baldusi/BalduHandbrake/hardware/BalduHandbrake-Connections-1.1-ADS1115.pdf

# BalduHandbrake v1.1

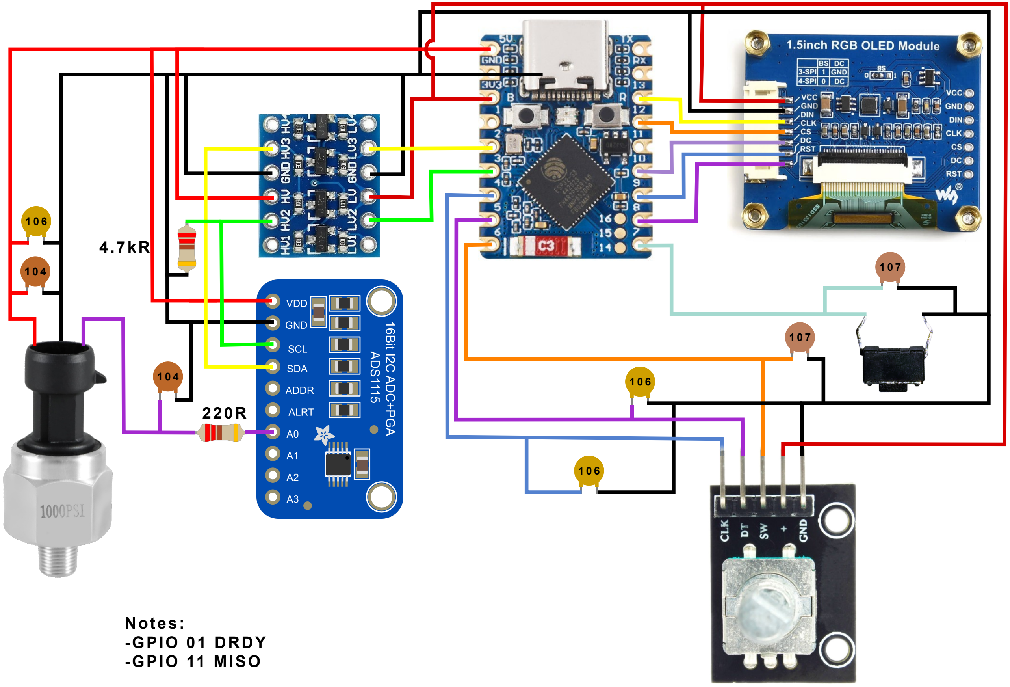
[picture p6: figure]
Notes: -GPIO 01 DRDY -GPIO 11 MISO
