baldusi/BalduHandbrake/hardware/BalduHandbrake-Connections-1.1-ADS122C04.pdf

# BalduHandbrake v1.1

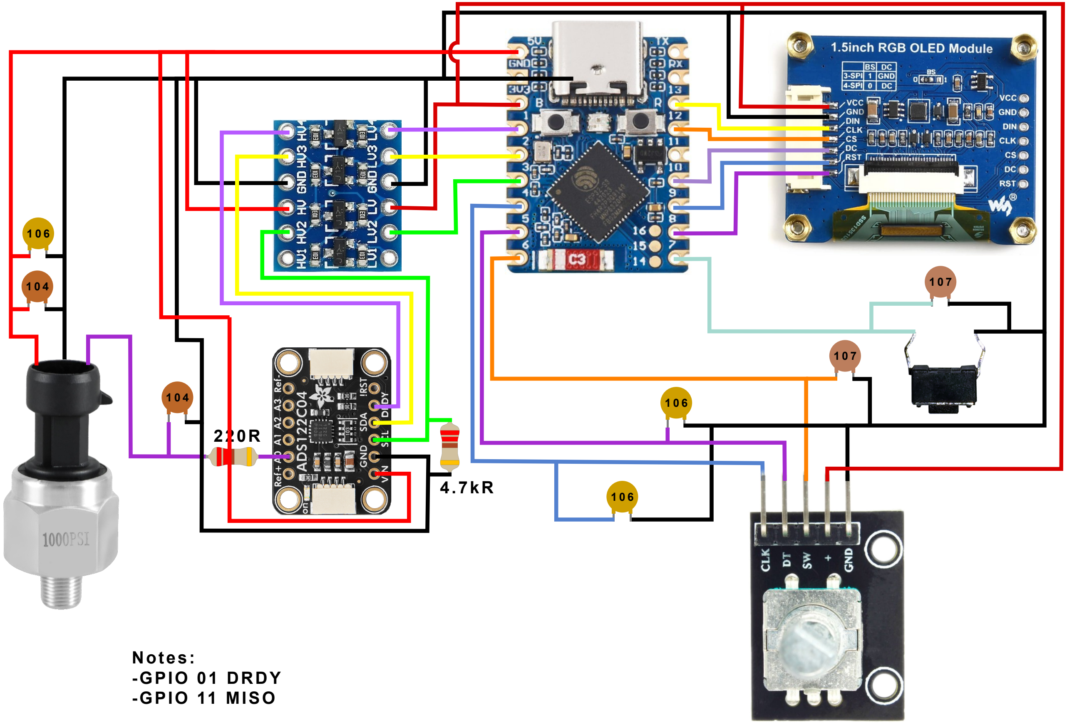
[picture p7: figure]
Notes: -GPIO 01 DRDY -GPIO 11 MISO
