baldusi/BalduHandbrake/images/5VPressure Transducer 1000psi.png

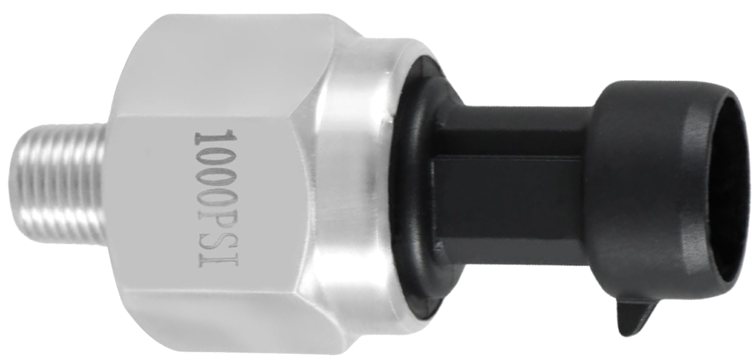
images/5VPressure Transducer 1000psi.png
