baldusi/BalduHandbrake/images/Adafruit-ADS122C04-QWIic01.png

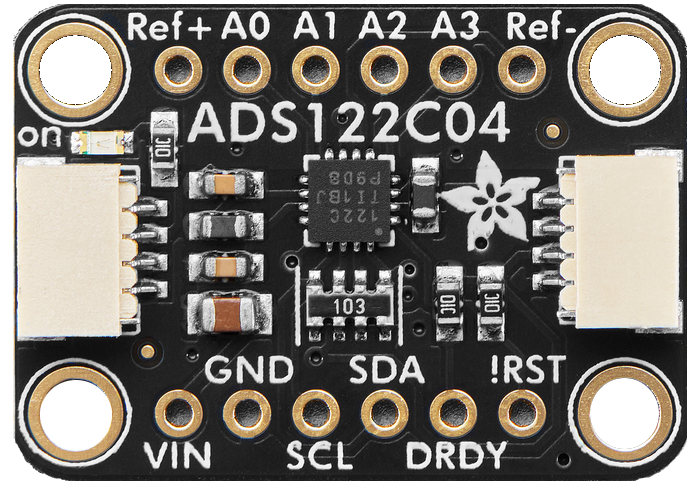
images/Adafruit-ADS122C04-QWIic01.png
