baldusi/BalduHandbrake/images/Adafruit-NAU7802-STEMMA-QT.png

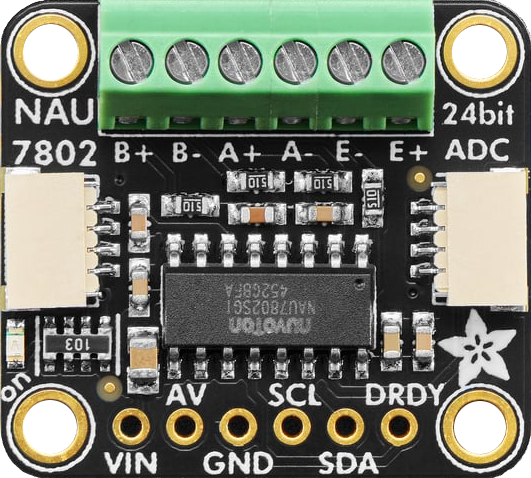
images/Adafruit-NAU7802-STEMMA-QT.png
