baldusi/BalduHandbrake/images/KY-040-RotaryEncoder-KY-040b.png

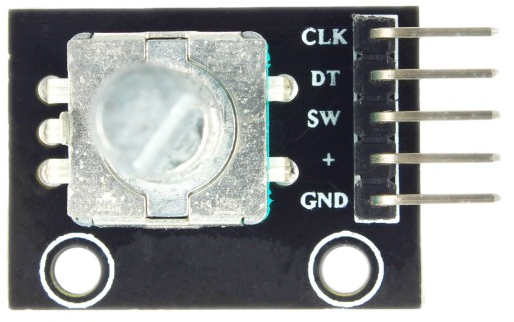
images/KY-040-RotaryEncoder-KY-040b.png
