baldusi/BalduHandbrake/images/ScrSht-LIVE01-FullData01.png

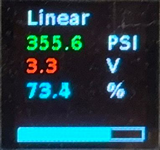
images/ScrSht-LIVE01-FullData01.png
