baldusi/BalduHandbrake/images/XFW-HX711.png

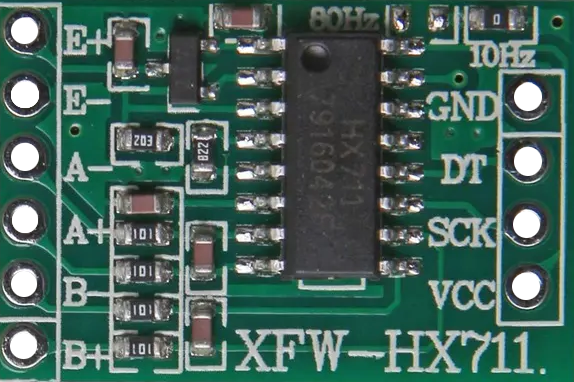
images/XFW-HX711.png
