baldusi/BalduHandbrake/hardware/BOM.xlsx

Sheet: ADS1115
Qty | Parts
1 | Waveshare ESP3-S3 Zero | https://www.amazon.com/waveshare-Mini-Development-Board-ESP32-S3FH4R2/dp/B0CS6VS1DJ/ref=sr_1_2
1 | 1/8 NPT 5V 500psi/1000psi Pressure Transducer | https://www.amazon.com/gp/product/B0CRQXGMWD/ref=ox_sc_act_title_3?th=1
1 | ADS1115 Module | https://www.amazon.com/HiLetgo-Converter-Programmable-Amplifier-Development/dp/B01DLHKMO2
1 | Logic Voltage Converter | https://www.amazon.com/SparkFun-12009-Logic-Converter-Bi-Directional/dp/B088FYQJYZ/ref=sr_1_4
1 | SSD1351 Module | https://www.amazon.com/1-5inch-RGB-OLED-Module-Interface/dp/B07V579YK2/ref=sr_1_1
1 | Momentary Button | https://www.amazon.com/uxcell-Momentary-Button-Switch-Mounting/dp/B0D5L7H9D2/ref=sr_1_4
1 | KY-040 Rotary Encoder | https://www.amazon.com/KY-040-Degrees-Encoder-15%C3%9716-5mm-Potentiometer/dp/B09LVG8ZGR/ref=sr_1_4
1 | 220 Ohm Resistor
1 | 4.7k Ohm Resistor
2 | 104 Capacitor
3 | 106 Capacitor
2 | 107 Capacitor

Sheet: ADS122C04
Qty | Parts
1 | Waveshare ESP3-S3 Zero | https://www.amazon.com/waveshare-Mini-Development-Board-ESP32-S3FH4R2/dp/B0CS6VS1DJ/ref=sr_1_2
1 | 1/8 NPT 5V 500psi/1000psi Pressure Transducer | https://www.amazon.com/gp/product/B0CRQXGMWD/ref=ox_sc_act_title_3?th=1
1 | ADS122C04 Module | https://www.adafruit.com/product/6432
1 | Logic Voltage Converter | https://www.amazon.com/SparkFun-12009-Logic-Converter-Bi-Directional/dp/B088FYQJYZ/ref=sr_1_4
1 | SSD1351 Module | https://www.amazon.com/1-5inch-RGB-OLED-Module-Interface/dp/B07V579YK2/ref=sr_1_1
1 | Momentary Button | https://www.amazon.com/uxcell-Momentary-Button-Switch-Mounting/dp/B0D5L7H9D2/ref=sr_1_4
1 | KY-040 Rotary Encoder | https://www.amazon.com/KY-040-Degrees-Encoder-15%C3%9716-5mm-Potentiometer/dp/B09LVG8ZGR/ref=sr_1_4
1 | 220 Ohm Resistor
1 | 4.7k Ohm Resistor
2 | 104 Capacitor
3 | 106 Capacitor
2 | 107 Capacitor

Sheet: ADS122C04-Load Cell
Qty | Parts
1 | Waveshare ESP3-S3 Zero | https://www.amazon.com/waveshare-Mini-Development-Board-ESP32-S3FH4R2/dp/B0CS6VS1DJ/ref=sr_1_2
1 | NA151 Single Point Load Cell Mechanic to Electronic Switch Weight Sensor (200kg) | https://www.amazon.com/Single-Mechanic-Electronic-Switch-Weight/dp/B088GY1HFL/ref=sr_1_7
1 | ADS122C04 Module | https://www.adafruit.com/product/6432
1 | SSD1351 Module | https://www.amazon.com/1-5inch-RGB-OLED-Module-Interface/dp/B07V579YK2/ref=sr_1_1
1 | Momentary Button | https://www.amazon.com/uxcell-Momentary-Button-Switch-Mounting/dp/B0D5L7H9D2/ref=sr_1_4
1 | KY-040 Rotary Encoder | https://www.amazon.com/KY-040-Degrees-Encoder-15%C3%9716-5mm-Potentiometer/dp/B09LVG8ZGR/ref=sr_1_4
2 | 220 Ohm Resistor
1 | 4.7k Ohm Resistor
4 | 104 Capacitor
3 | 106 Capacitor
2 | 107 Capacitor

Sheet: NAU7802
Qty | Parts
1 | Waveshare ESP3-S3 Zero | https://www.amazon.com/waveshare-Mini-Development-Board-ESP32-S3FH4R2/dp/B0CS6VS1DJ/ref=sr_1_2
1 | NA151 Single Point Load Cell Mechanic to Electronic Switch Weight Sensor (200kg) | https://www.amazon.com/Single-Mechanic-Electronic-Switch-Weight/dp/B088GY1HFL/ref=sr_1_7
1 | NAU7802 Module | https://www.amazon.com/Acquisition-Electronic-Collection-Biomedical-Automation/dp/B0GXJB7GX5
1 | SSD1351 Module | https://www.amazon.com/1-5inch-RGB-OLED-Module-Interface/dp/B07V579YK2/ref=sr_1_1
1 | Momentary Button | https://www.amazon.com/uxcell-Momentary-Button-Switch-Mounting/dp/B0D5L7H9D2/ref=sr_1_4
1 | KY-040 Rotary Encoder | https://www.amazon.com/KY-040-Degrees-Encoder-15%C3%9716-5mm-Potentiometer/dp/B09LVG8ZGR/ref=sr_1_4
2 | 220 Ohm Resistor
1 | 4.7k Ohm Resistor
4 | 104 Capacitor
3 | 106 Capacitor
2 | 107 Capacitor
