baldusi/BalduHandbrake/images/ScrSht-NavMode07-Calibration02.png

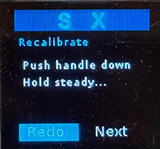
images/ScrSht-NavMode07-Calibration02.png
