baldusi/BalduHandbrake/images/ScrSht-NavMode07-Calibration03.png

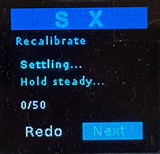
images/ScrSht-NavMode07-Calibration03.png
