baldusi/BalduHandbrake/images/ScrSht-NavMode07-Calibration04.png

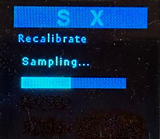
images/ScrSht-NavMode07-Calibration04.png
