baldusi/BalduHandbrake/images/ScrSht-NavMode07-Calibration05.png

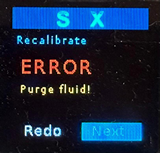
images/ScrSht-NavMode07-Calibration05.png
