baldusi/BalduHandbrake/images/ScrSht-NavMode07-Calibration06.png

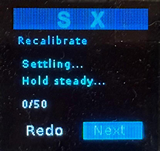
images/ScrSht-NavMode07-Calibration06.png
