baldusi/BalduHandbrake/images/ScrSht-NavMode07-Calibration07.png

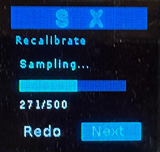
images/ScrSht-NavMode07-Calibration07.png
