baldusi/BalduHandbrake/images/ScrSht-NavMode07-Calibration08.png

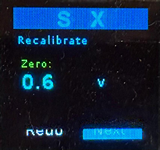
images/ScrSht-NavMode07-Calibration08.png
