baldusi/BalduHandbrake/images/ScrSht-NavMode07-Calibration09.png

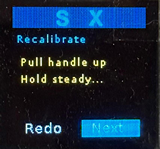
images/ScrSht-NavMode07-Calibration09.png
