baldusi/BalduHandbrake/images/ScrSht-NavMode07-Calibration10.png

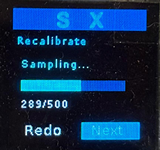
images/ScrSht-NavMode07-Calibration10.png
