baldusi/BalduHandbrake/images/ScrSht-NavMode07-Calibration12.png

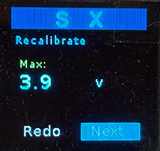
images/ScrSht-NavMode07-Calibration12.png
