baldusi/BalduHandbrake/images/ScrSht-NavMode07-Calibration13.png

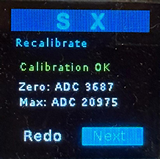
images/ScrSht-NavMode07-Calibration13.png
