baldusi/BalduHandbrake/images/ScrSht-NavMode07-Calibration14.png

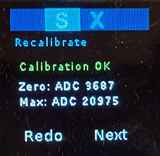
images/ScrSht-NavMode07-Calibration14.png
