baldusi/BalduHandbrake/images/ScrSht-NavMode07-Calibration15.png

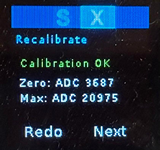
images/ScrSht-NavMode07-Calibration15.png
