baldusi/BalduHandbrake/images/ScrSht-NavMode07-Calibration16.png

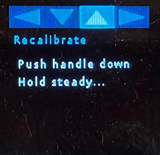
images/ScrSht-NavMode07-Calibration16.png
