baldusi/BalduHandbrake/hardware/BalduHandbrake-Connections-1.1-ADS122C04-Load-Cell.pdf

# BalduHandbrake v1.1 1 0 4

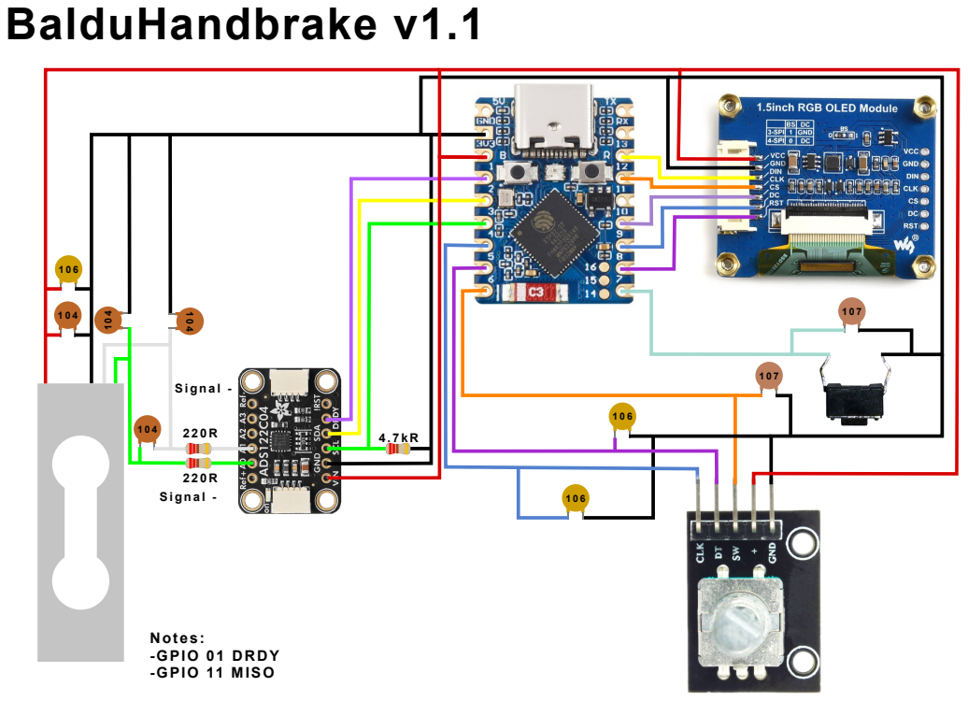
[picture p51: page 1]
Notes: -GPIO 01 DRDY -GPIO 11 MISO
