baldusi/BalduHandbrake/hardware/BalduHandbrake-Connections-1.1-HX711.pdf

# BalduHandbrake v1.1 1 0 4

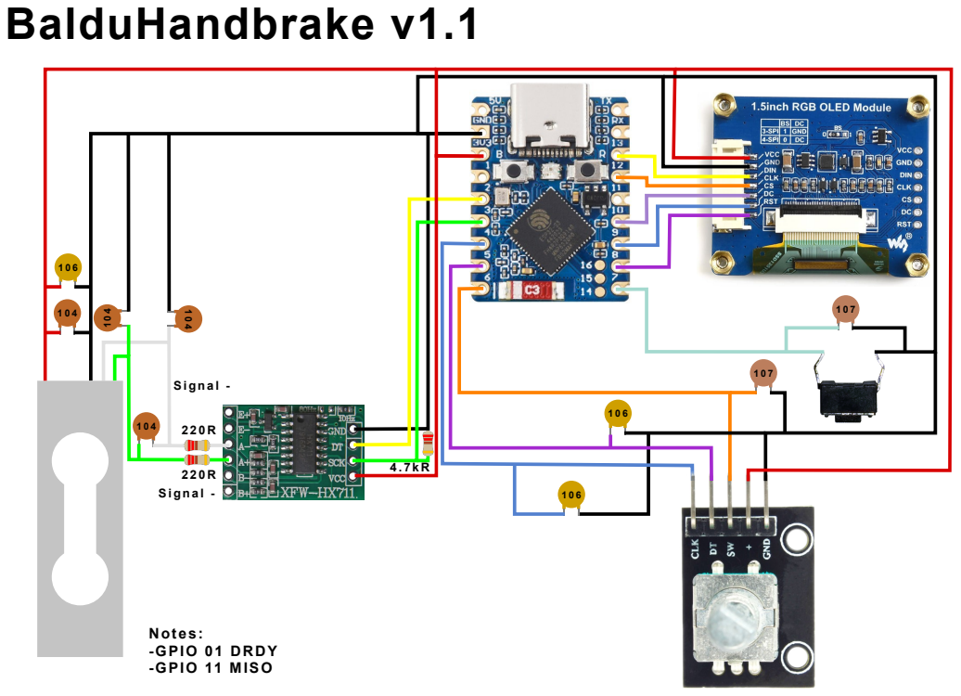
[picture p52: page 1]
Notes: -GPIO 01 DRDY -GPIO 11 MISO
