baldusi/BalduHandbrake/hardware/BalduHandbrake-Connections-1.1-NAU7802.pdf

# BalduHandbrake v1.1 1 0 4

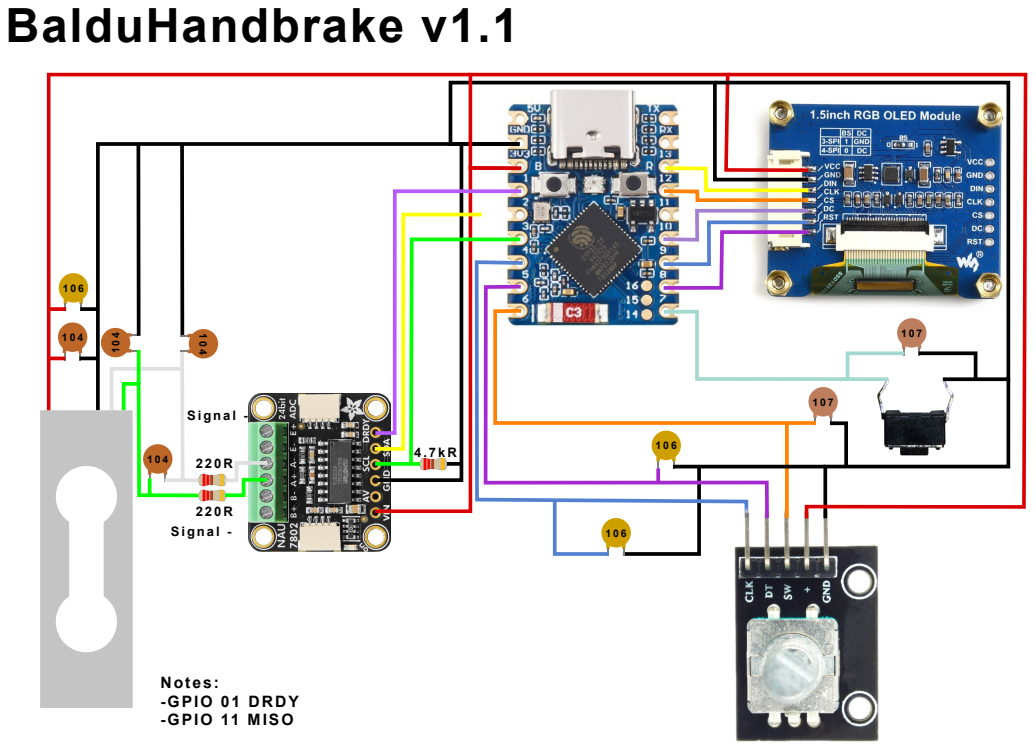
[picture p53: page 1]
Notes: -GPIO 01 DRDY -GPIO 11 MISO
