baldusi/BalduHandbrake/config.h

#define CONFIG_H
#include <Arduino.h>
#define FW_VERSION          "v1.5.6"
#define FW_BUILD            __DATE__ " " __TIME__   // or use a CI build number later
#define USB_SERIAL_STR       "BalduHandbrake-v1"
#define USB_PRODUCT_STR      "Baldu Handbrake"
#define USB_MANUFACTURER_STR "Baldu Handbrake Project"
    #define ADC_DRDY_PIN            -1
#define I2C_SCL_PIN           2
#define I2C_SDA_PIN           3
#define ROTARY_CHANNEL_A_PIN  4
#define ROTARY_CHANNEL_B_PIN  5
#define ROTARY_BUTTON_PIN     6
#define OLED_MOSI             13
#define OLED_SCK              12
#define OLED_MISO             -1 //11
#define OLED_CS               10
#define OLED_DC               9
#define OLED_RST              8
#define HOLD_BUTTON_PIN       7
#define I2C_WIRE_SPEED        400000
#define SCREEN_WIDTH          128
#define SCREEN_HEIGHT         128
#define Z_AXIS_MIN            0
#define Z_AXIS_MAX            4095
    #define SENSOR_UNIT_MAX             500     // PSI full scale
    #define ADC_SPEC_ZERO              2667     // 0.50V: transducer zero
    #define ADC_SPEC_FULL             24000     // 4.50V: transducer full scale
    #define ADC_FAIL_THRESHOLD         1333     // below 0.25V: disconnected
    #define ADC_OVER_THRESHOLD        25707     // near VCC: saturation
    #define CALIB_REJECT_ZERO_LOW     ADC_FAIL_THRESHOLD
    #define CALIB_REJECT_MAX_HIGH     ADC_OVER_THRESHOLD
static const char* const CURVE_NAMES[] = {
    "Linear",
    "Rally Soft",
    "Rally Aggr",
    "Drift Snap",
    "Wet",
    "S-Curve"
};
#define NUM_CURVES (sizeof(CURVE_NAMES) / sizeof(CURVE_NAMES[0]))
enum CurveID : uint8_t {
    CURVE_LINEAR      = 0,
    CURVE_RALLY_SOFT  = 1,
    CURVE_RALLY_AGGR  = 2,
    CURVE_DRIFT_SNAP  = 3,
    CURVE_WET         = 4,
    CURVE_S_CURVE     = 5
};
inline uint8_t curveToLutIndex(uint8_t curveId) {
    switch (curveId) {
        case CURVE_RALLY_SOFT:  return 0;
        case CURVE_RALLY_AGGR:  return 1;
        case CURVE_WET:         return 2;
        case CURVE_S_CURVE:     return 3;
        default:                return 0xFF;
    }
}
enum HoldMode : uint8_t {
    HOLD_GAME     = 0,
    HOLD_FIRMWARE = 1
};
enum SensorFault : uint8_t {
    FAULT_NONE         = 0x00,
    FAULT_DISCONNECTED = 0x01,
    FAULT_LOW          = 0x02,
    FAULT_SATURATION   = 0x04,
};
enum LiveScreen : uint8_t {
    LIVE_FULL_DATA = 0,
    LIVE_CLEAN     = 1,
    LIVE_BAR_ONLY  = 2,
    LIVE_DARK      = 3
};
#define NUM_LIVE_SCREENS 4
enum Language : uint8_t {
    LANG_EN = 0,
    LANG_ES = 1,
    NUM_LANGUAGES
};
#define DEFAULT_LANGUAGE  LANG_EN
enum DisplayState : uint8_t {
    DISPLAY_LIVE       = 0,
    DISPLAY_MENU_LIST  = 1,
    DISPLAY_EDIT_VALUE = 2
};
    #define DEFAULT_SAMPLE_RATE_HZ   1000	//We consider this the standard
#define DEFAULT_DISPLAY_RATE_HZ     30
#define DEFAULT_DEBOUNCE_MS         50
#define DEFAULT_ERROR_RESET_MS     250
#define DEFAULT_DEADZONE_LOW        50
#define DEFAULT_DEADZONE_HIGH       50
#define DEFAULT_CURVE_INDEX          0
#define DEFAULT_SNAP_THRESHOLD     550
#define DEFAULT_HOLD_MODE            0
#define DEFAULT_LIVE_SCREEN          0
#define DEFAULT_LIVE_DARK_TIMEOUT  5000
#define COLOR_BLACK    0x0000
#define COLOR_WHITE    0xFFFF
#define COLOR_RED      0xF800
#define COLOR_GREEN    0x07E0
#define COLOR_BLUE     0x001F
#define COLOR_CYAN     0x07FF
#define COLOR_YELLOW   0xFFE0
#define COLOR_MAGENTA  0xF81F
#define COLOR_ORANGE   0xFD20
#define LIVE_BG_COLOR       COLOR_BLACK
#define LIVE_FG_COLOR       COLOR_WHITE
#define LIVE_VALUE_COLOR    COLOR_CYAN
#define LIVE_LABEL_COLOR    COLOR_WHITE
#define LIVE_OK_COLOR       COLOR_GREEN
#define LIVE_WARN_COLOR     COLOR_YELLOW
#define LIVE_ERROR_COLOR    COLOR_RED
#define EDIT_BG_COLOR       COLOR_BLACK
#define EDIT_TITLE_COLOR    NAV_NORMAL_FG
#define EDIT_VALUE_COLOR    COLOR_CYAN
#define EDIT_LABEL_COLOR    COLOR_WHITE
#define NAV_BOX_COUNT      4
#define NAV_BOX_W         32
#define NAV_BOX_H         20
#define NAV_SEPARATOR_PX   2
static const int16_t NAV_BOX_X[NAV_BOX_COUNT] = { 0, 96, 64, 32 };
static const int16_t NAV_BOX_Y[NAV_BOX_COUNT] = { 0,  0,  0,  0 };
#define NAV_NORMAL_BG    0x08A5
#define NAV_SELECTED_BG  0x03DF
#define NAV_NORMAL_FG    0x1B39
#define NAV_SELECTED_FG  0xFFFF
struct DeviceConfig {
    uint8_t  curveIndex;
    uint16_t snapThreshold;
    uint16_t deadzoneLow;
    uint16_t deadzoneHigh;
    uint8_t  holdMode;
    uint8_t  liveScreen;
    uint16_t liveDarkTimeoutMs;
    uint8_t  language;
    uint16_t sampleRateHz;
    uint16_t displayRateHz;
    uint8_t  debounceMs;
    uint16_t calAdcZero;
    uint16_t calAdcMax;
};
inline DeviceConfig getDefaultConfig() {
    DeviceConfig cfg;
    cfg.curveIndex        = DEFAULT_CURVE_INDEX;
    cfg.snapThreshold     = DEFAULT_SNAP_THRESHOLD;
    cfg.deadzoneLow       = DEFAULT_DEADZONE_LOW;
    cfg.deadzoneHigh      = DEFAULT_DEADZONE_HIGH;
    cfg.holdMode          = DEFAULT_HOLD_MODE;
    cfg.liveScreen        = DEFAULT_LIVE_SCREEN;
    cfg.liveDarkTimeoutMs = DEFAULT_LIVE_DARK_TIMEOUT;
    cfg.language          = DEFAULT_LANGUAGE;
    cfg.sampleRateHz      = DEFAULT_SAMPLE_RATE_HZ;
    cfg.displayRateHz     = DEFAULT_DISPLAY_RATE_HZ;
    cfg.debounceMs        = DEFAULT_DEBOUNCE_MS;
    cfg.calAdcZero        = ADC_SPEC_ZERO;
    cfg.calAdcMax         = ADC_SPEC_FULL;
    return cfg;
}
struct LiveData {
    uint16_t rawAdc;
    uint16_t centiVolts;
    uint32_t centiUnit;
    uint16_t centiPercent;
    uint16_t axisOutput;
    bool     holdActive;
    bool     sensorLow;         // Below calibrated zero (low pressure / negative force)
    bool     sensorFail;        // Sensor disconnected or open circuit
    bool     sensorSaturation;  // Over range (overpressure / rail saturation)
};
enum ParamType : uint8_t {
    PARAM_NONE   = 0,
    PARAM_BOOL   = 1,
    PARAM_UINT8  = 2,
    PARAM_UINT16 = 3,
    PARAM_UINT32 = 4
};
#define MAX_EDIT_PARAMS 6
typedef void (*DrawFunc)(void);
struct EditScreen {
    const char* title;
    uint8_t     numParams;
    void*       paramPtrs[MAX_EDIT_PARAMS];
    ParamType   paramTypes[MAX_EDIT_PARAMS];
    uint8_t     numButtons;
    DrawFunc    drawFunc;
};
#define NUM_NVS_PROFILES  5
#define NVS_NAMESPACE     "bhbrake"
enum CalibState : uint8_t {
    CALIB_IDLE            = 0,   // Not calibrating
    CALIB_PROMPT_ZERO     = 1,   // "Push handle down" prompt
    CALIB_SETTLING_ZERO   = 2,   // Waiting for readings to stabilize at rest
    CALIB_SAMPLING_ZERO   = 3,   // Collecting 500 samples (5 seconds)
    CALIB_RESULT_ZERO     = 4,   // Show zero result, continue or retry
    CALIB_PROMPT_MAX      = 5,   // "Pull handle up" prompt
    CALIB_SETTLING_MAX    = 6,   // Waiting for readings to stabilize at max pull
    CALIB_SAMPLING_MAX    = 7,   // Collecting 500 samples (5 seconds)
    CALIB_RESULT_MAX      = 8,   // Show max result
    CALIB_DONE            = 9,   // Calibration complete, show summary
    CALIB_ERROR           = 10   // Error condition (bad readings)
};
#define CALIB_SAMPLE_COUNT        500   // Total samples to collect
#define CALIB_SAMPLE_DURATION_MS  5000  // Duration of sample collection window
#define CALIB_OUTLIER_REJECT_PCT  0.05f // Reject top and bottom 5% of samples
#define CALIB_STABILITY_COUNT     50    // Consecutive stable samples required (~300ms)
#define CALIB_STABILITY_BAND_PCT  5     // Max deviation as % of ADC span (PLACEHOLDER)
#define CALIB_ZERO_CEILING_PCT    15    // Zero readings must be below this % of span (PLACEHOLDER)
#define CALIB_MAX_FLOOR_PCT       30    // Max readings must be above this % of span (PLACEHOLDER)
struct CalibData {
    CalibState    state;
    uint16_t      samples[CALIB_SAMPLE_COUNT];
    uint16_t      sampleCount;
    unsigned long samplingStartMs;
    uint16_t      settleRingBuf[CALIB_STABILITY_COUNT];  // Rolling window
    uint8_t       settleRingIdx;                          // Current write position
    uint8_t       settleStableCount;                      // Consecutive stable readings
    uint32_t      settleRunningSum;                       // Sum of ring buffer values
    bool          settleBufferFull;                        // Ring buffer filled at least once
    uint16_t      resultAdcZero;
    uint16_t      resultAdcMax;
    uint16_t      resultCentiVolts;   // Voltage of last result for display
    const char*   errorMsg;           // Points into STRING_TABLE or NULL
};
