baldusi/BalduHandbrake/assets.h

/*  BalduHandrake
    Open Source Hydraulic Simracing Handbrake
    Copyright (c) 2026 Alejandro Belluscio
    Additional copyright holders listed inline below.
    This file is licensed under the Apache 2.0 license
    Full licence text: see LICENSE in this repository. 
*/
// ============================================================================
// assets.h — All custom images and fonts are defined here
// ============================================================================

#ifndef ASSETS_H
#define ASSETS_H

#include <stdint.h>

// ============================================================================
//  ASSET TYPE ENUM
// ============================================================================
typedef enum {
    ASSET_1BPP_MASK   = 0,   // 1-bit mask (XBM-style) — draw with foreground colour
    ASSET_RGB565      = 1,   // plain opaque 16-bit RGB565
    ASSET_RGB565_MASK = 2    // 16-bit RGB565 + separate 1-bit mask (transparency)
} AssetType;

// ============================================================================
//  COMMON ASSET DESCRIPTOR (dimensions + type embedded)
// ============================================================================
typedef struct {
    AssetType    type;      // tells the draw helper how to interpret the data
    uint16_t     width;
    uint16_t     height;
    const void*  data;      // uint8_t*  for 1BPP, uint16_t* for RGB565
    const void*  mask;      // only used for ASSET_RGB565_MASK, otherwise NULL
} AssetDesc;

// ============================================================================
//  DECLARATION MACROS (for future assets — keeps the file clean)
// ============================================================================
#define DECLARE_1BPP(name, w, h) \
	extern const AssetDesc name; \
    extern const uint8_t name##_bits[];

#define DECLARE_RGB565(name, w, h) \
    extern const AssetDesc name; \
    extern const uint16_t name##_pixels[];

#define DECLARE_RGB565_MASKED(name, w, h) \
    extern const AssetDesc name; \
    extern const uint16_t name##_pixels[]; \
    extern const uint8_t name##_mask[];

// ============================================================================
//  NAVIGATION BAR ARROWS (32×20 px, opaque RGB565)
// ============================================================================

DECLARE_RGB565(icon_nav_left_normal, 32, 20);
const uint16_t icon_nav_left_normal_pixels[] = {
  0x08a5, 0x08a5, 0x08a5, 0x08a5, 0x08a5, 0x08a5, 0x08a5, 0x08a5, 0x08a5, 0x08a5, 0x08a5, 0x08a5, 
  0x08a5, 0x08a5, 0x08a5, 0x08a5, 0x08a5, 0x08a5, 0x08a5, 0x08a5, 0x08a5, 0x08a5, 0x08a5, 0x08a5, 
  0x08a5, 0x08a5, 0x08a5, 0x08a5, 0x08a5, 0x08a5, 0x08a5, 0x08a5, 0x08a5, 0x08a5, 0x08a5, 0x08a5, 
  0x08a5, 0x08a5, 0x08a5, 0x08a5, 0x08a5, 0x08a5, 0x08a5, 0x08a5, 0x08a5, 0x08a5, 0x08a5, 0x08a5, 
  0x08a5, 0x08a5, 0x08a5, 0x08a5, 0x08a5, 0x08a5, 0x08a5, 0x08a5, 0x08a5, 0x08a5, 0x08a5, 0x08a5, 
  0x08a5, 0x08a5, 0x08a5, 0x08a5, 0x08a5, 0x08a5, 0x08a5, 0x08a5, 0x08a5, 0x08a5, 0x08a5, 0x08a5, 
  0x08a5, 0x08a5, 0x08a5, 0x08a5, 0x08a5, 0x08a5, 0x08a5, 0x08a5, 0x08a5, 0x08a5, 0x08a5, 0x08a5, 
  0x08a5, 0x08a5, 0x08a5, 0x08a5, 0x08a5, 0x08a5, 0x08a5, 0x08a5, 0x08a5, 0x08a5, 0x08a5, 0x08a5, 
  0x08a5, 0x08a5, 0x08a5, 0x08a5, 0x08a5, 0x08a5, 0x08a5, 0x08a5, 0x08a5, 0x08a5, 0x08a5, 0x08a5, 
  0x08a5, 0x08a5, 0x08a5, 0x08a5, 0x08a5, 0x08a5, 0x08a5, 0x08a5, 0x08a5, 0x08a5, 0x08a5, 0x08a5, 
  0x08a5, 0x0929, 0x11f0, 0x12b6, 0x08a5, 0x08a5, 0x08a5, 0x08a5, 0x08a5, 0x08a5, 0x08a5, 0x08a5, 
  0x08a5, 0x08a5, 0x08a5, 0x08a5, 0x08a5, 0x08a5, 0x08a5, 0x08a5, 0x08a5, 0x08a5, 0x08a5, 0x08a5, 
  0x08a5, 0x08a5, 0x08a5, 0x08a5, 0x08a5, 0x08c6, 0x098c, 0x1252, 0x1b18, 0x1b39, 0x1b39, 0x1b39, 
  0x08a5, 0x08a5, 0x08a5, 0x08a5, 0x08a5, 0x08a5, 0x08a5, 0x08a5, 0x08a5, 0x08a5, 0x08a5, 0x08a5, 
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

};

// The actual descriptor instance
const AssetDesc icon_live_hold = {
    .type   = ASSET_RGB565,
    .width  = 60,
    .height = 20,
    .data   = icon_live_hold_pixels,
    .mask   = NULL
};

#endif // ASSETS_H
