baldusi/BalduHandbrake/curves.h

/*  BalduHandrake
	Open Source Hydraulic Simracing Handbrake
	Copyright (c) 2026 Alejandro Belluscio
	Additional copyright holders listed inline below.
	This file is licensed under the Apache 2.0 license
	Full licence text: see LICENSE in this repository. 
*/
// ============================================================================
// curves.h — Curve Correction Lookup Tables
// ============================================================================
// Pre-computed LUTs for the handbrake response curves. Each table maps a
// normalized input (0–4095, subdivided into 1024 segments + 1 duplicate
// sentinel) to a curved output (0–4095).
//
// The sensor pipeline indexes these with 2-bit fractional interpolation:
//   index = normValue >> 2       (0–1023)
//   frac  = normValue & 3        (0–3)
//   result = y0 + (y1 - y0) * frac / 4
// The extra 1025th entry (duplicate of entry 1024) avoids a bounds check
// when interpolating the last segment.
//
// LUT index mapping (see curveToLutIndex() in config.h):
//   LUT 0 = Rally Soft    (t^2.2)
//   LUT 1 = Rally Aggressive (t^0.75)
//   LUT 2 = Wet           (t^3.5)
//   LUT 3 = S-Curve       (1 / (1 + exp(-8*(t-0.5))))
//
// Linear and Drift Snap are computed directly — they don't use LUTs.
//
// To regenerate or add curves, use this Python script:
// -----------------------------------------------------------------------
//   import math
//
//   def normalize_curve(f, num_points=1024):
//       values = [f(j / (num_points - 1.0)) for j in range(num_points)]
//       f_min, f_max = min(values), max(values)
//       if f_max == f_min: return [0] * num_points
//       return [max(0, min(4095, round(((v - f_min) / (f_max - f_min)) * 4095)))
//               for v in values]
//
//   curves = [
//       ("Rally Soft",       lambda t: t ** 2.2),
//       ("Rally Aggressive", lambda t: t ** 0.75),
//       ("Wet",              lambda t: t ** 3.5),
//       ("S-Curve",          lambda t: 1 / (1 + math.exp(-8 * (t - 0.5)))),
//   ]
//
//   for i, (name, f) in enumerate(curves):
//       arr = normalize_curve(f)
//       arr.append(arr[-1])  # sentinel for interpolation
//       print(f"// LUT {i}: {name}")
//       print(f"const uint16_t CURVE_LUT_{i}[1025] = {{")
//       for row_start in range(0, len(arr), 16):
//           print("    " + ", ".join(f"{v:4d}" for v in arr[row_start:row_start+16]) + ",")
//       print("};")
//       print()
// -----------------------------------------------------------------------
//
// Project:  BalduHandbrake — Open Source Hydraulic Simracing Handbrake
// License:  Apache 2.0
// ============================================================================
#ifndef CURVES_H
#define CURVES_H

#include <Arduino.h>

// Number of LUT entries (1024 segments + 1 sentinel)
#define CURVE_LUT_SIZE 1025

// Number of available LUTs (curves that use table lookup)
#define NUM_CURVE_LUTS 4

// ============================================================================
//  LUT 0: Rally Soft  (t^2.2)
//  Gentle initial response, progressive buildup. Good for rally stages
//  where smooth modulation matters more than snap response.
// ============================================================================
const uint16_t CURVE_LUT_0[CURVE_LUT_SIZE] = {
  0, 0, 0, 0, 0, 0, 0, 0, 0, 0, 0, 0, 0, 0, 0, 0, 0, 0, 1, 1, 1, 1, 1, 1, 1, 1, 1, 1, 1, 2, 2, 2, 2, 2, 2, 2, 3, 3, 3, 3, 3, 3, 4, 4, 4, 4, 4, 5, 5, 5, 5, 6, 6, 6, 6, 7, 7, 7, 7, 8, 8, 8, 9, 9, 9, 10, 10, 10, 11, 11, 11, 12, 12, 12, 13, 13, 13, 14, 14, 15, 15, 15, 16, 16, 17, 17, 18, 18, 19, 19, 19, 20, 20, 21, 21, 22, 22, 23, 24, 24, 25, 25, 26, 26, 27, 27, 28, 29, 29, 30, 30, 31, 32, 32, 33, 33, 34, 35, 35, 36, 37, 37, 38, 39, 39, 40, 41, 42, 42, 43, 44, 45, 45, 46, 47, 48, 48, 49, 50, 51, 52, 52, 53, 54, 55, 56, 57, 57, 58, 59, 60, 61, 62, 63, 64, 64, 65, 66, 67, 68, 69, 70, 71, 72, 73, 74, 75, 76, 77, 78, 79, 80, 81, 82, 83, 84, 85, 86, 87, 88, 90, 91, 92, 93, 94, 95, 96, 97, 99, 100, 101, 102, 103, 104, 106, 107, 108, 109, 110, 112, 113, 114, 115, 117, 118, 119, 121, 122, 123, 124, 126, 127, 128, 130, 131, 132, 134, 135, 136, 138, 139, 141, 142, 143, 145, 146, 148, 149, 151, 152, 154, 155, 157, 158, 160, 161, 163, 164, 166, 167, 169, 170, 172, 173, 175, 176, 178, 180, 181, 183, 184, 186, 188, 189, 191, 193, 194, 196, 198, 199, 201, 203, 205, 206, 208, 210, 211, 213, 215, 217, 219, 220, 222, 224, 226, 228, 229, 231, 233, 235, 237, 239, 240, 242, 244, 246, 248, 250, 252, 254, 256, 258, 260, 262, 264, 266, 268, 270, 272, 274, 276, 278, 280, 282, 284, 286, 288, 290, 292, 294, 296, 298, 300, 302, 305, 307, 309, 311, 313, 315, 318, 320, 322, 324, 326, 329, 331, 333, 335, 338, 340, 342, 344, 347, 349, 351, 354, 356, 358, 361, 363, 365, 368, 370, 372, 375, 377, 380, 382, 384, 38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
};

// ============================================================================
//  LUT 1: Rally Aggressive  (t^0.75)
//  Strong initial bite, early response. For stages where you need immediate
//  braking force and fine control at the top end.
// ============================================================================
const uint16_t CURVE_LUT_1[CURVE_LUT_SIZE] = {
  0, 23, 38, 52, 64, 76, 87, 97, 108, 118, 127, 137, 146, 155, 164, 173, 181, 190, 198, 206, 214, 222, 230, 238, 245, 253, 261, 268, 276, 283, 290, 297, 305, 312, 319, 326, 333, 340, 346, 353, 360, 367, 373, 380, 387, 393, 400, 406, 413, 419, 426, 432, 438, 445, 451, 457, 463, 470, 476, 482, 488, 494, 500, 506, 512, 518, 524, 530, 536, 542, 548, 554, 560, 565, 571, 577, 583, 588, 594, 600, 606, 611, 617, 623, 628, 634, 639, 645, 650, 656, 661, 667, 672, 678, 683, 689, 694, 700, 705, 711, 716, 721, 727, 732, 737, 743, 748, 753, 758, 764, 769, 774, 779, 785, 790, 795, 800, 805, 811, 816, 821, 826, 831, 836, 841, 846, 851, 856, 861, 867, 872, 877, 882, 887, 892, 897, 902, 907, 911, 916, 921, 926, 931, 936, 941, 946, 951, 956, 961, 965, 970, 975, 980, 985, 990, 994, 999, 1004, 1009, 1014, 1018, 1023, 1028, 1033, 1037, 1042, 1047, 1052, 1056, 1061, 1066, 1071, 1075, 1080, 1085, 1089, 1094, 1099, 1103, 1108, 1113, 1117, 1122, 1126, 1131, 1136, 1140, 1145, 1149, 1154, 1159, 1163, 1168, 1172, 1177, 1181, 1186, 1190, 1195, 1199, 1204, 1208, 1213, 1218, 1222, 1226, 1231, 1235, 1240, 1244, 1249, 1253, 1258, 1262, 1267, 1271, 1276, 1280, 1284, 1289, 1293, 1298, 1302, 1306, 1311, 1315, 1320, 1324, 1328, 1333, 1337, 1341, 1346, 1350, 1354, 1359, 1363, 1367, 1372, 1376, 1380, 1385, 1389, 1393, 1398, 1402, 1406, 1410, 1415, 1419, 1423, 1428, 1432, 1436, 1440, 1445, 1449, 1453, 1457, 1462, 1466, 1470, 1474, 1478, 1483, 1487, 1491, 1495, 1500, 1504, 1508, 1512, 1516, 1520, 1525, 1529, 1533, 15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
};

// ============================================================================
//  LUT 2: Wet  (t^3.5)
//  Very soft initial response, strong exponential ramp. Simulates reduced
//  grip conditions where gentle modulation prevents lockup.
// ============================================================================
const uint16_t CURVE_LUT_2[CURVE_LUT_SIZE] = {
  0, 0, 0, 0, 0, 0, 0, 0, 0, 0, 0, 0, 0, 0, 0, 0, 0, 0, 0, 0, 0, 0, 0, 0, 0, 0, 0, 0, 0, 0, 0, 0, 0, 0, 0, 0, 0, 0, 0, 0, 0, 0, 0, 0, 0, 0, 0, 0, 0, 0, 0, 0, 0, 0, 0, 0, 0, 0, 0, 0, 0, 0, 0, 0, 0, 0, 0, 0, 0, 0, 0, 0, 0, 0, 0, 0, 0, 0, 1, 1, 1, 1, 1, 1, 1, 1, 1, 1, 1, 1, 1, 1, 1, 1, 1, 1, 1, 1, 1, 1, 1, 1, 1, 1, 1, 1, 1, 2, 2, 2, 2, 2, 2, 2, 2, 2, 2, 2, 2, 2, 2, 2, 2, 2, 3, 3, 3, 3, 3, 3, 3, 3, 3, 3, 3, 3, 4, 4, 4, 4, 4, 4, 4, 4, 4, 4, 4, 5, 5, 5, 5, 5, 5, 5, 5, 6, 6, 6, 6, 6, 6, 6, 6, 7, 7, 7, 7, 7, 7, 8, 8, 8, 8, 8, 8, 8, 9, 9, 9, 9, 9, 10, 10, 10, 10, 10, 10, 11, 11, 11, 11, 12, 12, 12, 12, 12, 13, 13, 13, 13, 14, 14, 14, 14, 15, 15, 15, 15, 16, 16, 16, 16, 17, 17, 17, 17, 18, 18, 18, 19, 19, 19, 19, 20, 20, 20, 21, 21, 21, 22, 22, 22, 23, 23, 23, 24, 24, 25, 25, 25, 26, 26, 26, 27, 27, 28, 28, 28, 29, 29, 30, 30, 30, 31, 31, 32, 32, 33, 33, 33, 34, 34, 35, 35, 36, 36, 37, 37, 38, 38, 39, 39, 40, 40, 41, 41, 42, 42, 43, 43, 44, 44, 45, 46, 46, 47, 47, 48, 48, 49, 50, 50, 51, 51, 52, 53, 53, 54, 55, 55, 56, 57, 57, 58, 59, 59, 60, 61, 61, 62, 63, 63, 64, 65, 66, 66, 67, 68, 69, 69, 70, 71, 72, 72, 73, 74, 75, 76, 76, 77, 78, 79, 80, 81, 81, 82, 83, 84, 85, 86, 87, 88, 88, 89, 90, 91, 92, 93, 94, 95, 96, 97, 98, 99, 100, 101, 102, 103, 104, 105, 106, 107, 108, 109, 110, 111, 112, 113, 114, 115, 117, 118, 119, 120, 121, 122, 123, 124, 126, 127, 128, 129, 130, 131, 133, 134, 135, 136, 138, 139, 140, 141, 143, 144, 145, 146, 148, 149, 150, 152, 153, 154, 156, 157, 158, 160, 161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
};

// ============================================================================
//  LUT 3: S-Curve  (1 / (1 + exp(-8*(t-0.5))))
//  Soft at both extremes, steep in the middle. Provides a natural-feeling
//  response with gentle initial engagement and smooth top-end rolloff.
// ============================================================================
const uint16_t CURVE_LUT_3[CURVE_LUT_SIZE] = {
  0, 1, 1, 2, 2, 3, 4, 4, 5, 5, 6, 7, 7, 8, 9, 9, 10, 11, 11, 12, 13, 13, 14, 15, 15, 16, 17, 18, 18, 19, 20, 20, 21, 22, 23, 23, 24, 25, 26, 27, 27, 28, 29, 30, 31, 31, 32, 33, 34, 35, 36, 36, 37, 38, 39, 40, 41, 42, 43, 44, 44, 45, 46, 47, 48, 49, 50, 51, 52, 53, 54, 55, 56, 57, 58, 59, 60, 61, 62, 63, 64, 65, 66, 67, 69, 70, 71, 72, 73, 74, 75, 76, 78, 79, 80, 81, 82, 83, 85, 86, 87, 88, 90, 91, 92, 93, 95, 96, 97, 99, 100, 101, 103, 104, 105, 107, 108, 109, 111, 112, 114, 115, 116, 118, 119, 121, 122, 124, 125, 127, 128, 130, 131, 133, 134, 136, 138, 139, 141, 142, 144, 146, 147, 149, 151, 152, 154, 156, 157, 159, 161, 163, 165, 166, 168, 170, 172, 174, 175, 177, 179, 181, 183, 185, 187, 189, 191, 193, 195, 197, 199, 201, 203, 205, 207, 209, 211, 213, 215, 217, 219, 222, 224, 226, 228, 230, 233, 235, 237, 239, 242, 244, 246, 249, 251, 253, 256, 258, 261, 263, 265, 268, 270, 273, 275, 278, 280, 283, 286, 288, 291, 293, 296, 299, 301, 304, 307, 310, 312, 315, 318, 321, 324, 326, 329, 332, 335, 338, 341, 344, 347, 350, 353, 356, 359, 362, 365, 368, 371, 374, 378, 381, 384, 387, 390, 394, 397, 400, 404, 407, 410, 414, 417, 420, 424, 427, 431, 434, 438, 441, 445, 449, 452, 456, 459, 463, 467, 471, 474, 478, 482, 486, 489, 493, 497, 501, 505, 509, 513, 517, 521, 525, 529, 533, 537, 541, 545, 549, 554, 558, 562, 566, 571, 575, 579, 584, 588, 592, 597, 601, 606, 610, 615, 619, 624, 628, 633, 638, 642, 647, 652, 656, 661, 666, 671, 676, 680, 685, 690, 695, 700, 705, 710, 715, 720,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
};

// ============================================================================
//  LUT POINTER ARRAY — for indexed access from applyCurveCorrection()
// ============================================================================
// Usage: curveLUTs[lutIndex][tableIndex]
// lutIndex is obtained from curveToLutIndex() in config.h.
static const uint16_t* const CURVE_LUTS[NUM_CURVE_LUTS] = {
    CURVE_LUT_0,
    CURVE_LUT_1,
    CURVE_LUT_2,
    CURVE_LUT_3
};

#endif // CURVES_H
