baldusi/BalduHandbrake/(commit log)

2026-04-02 v0.9.1 - display fixes: hysteresis, arc borders, hold indicator, overlay timing
    [display.cpp, display.h, ui.cpp]
2026-04-03 v1.0 - Param save & load working, parms correctly loading while navigating, finished calibration
    [display.cpp, display.h, ui.cpp]
2026-04-03 v1.0.1 - Sensor filtering, copyright notice, README.md
2026-04-19 v1.2 - Corrected bugs, preliminary support for ADS122C04 and hardware v1.1
    [BOM.xlsx]
2026-04-25 v1.4 - Added HX support, abstraction, GAIN bugs and documentation.
    [BalduHandbrake.ino, ads1115.h, ads122c04_loadcell.h, config.h, hx711.h, nau7802.h, sensor.cpp, sensor.h]
2026-04-26 v1.4.1 - Added documentations, screenshots, bugs and a CHANGELOG.md
    [BOM.xlsx]
2026-04-27 v1.5.0 - Bugs, new build infrastructure, first V1.2 hardware spec
    [BalduHandbrake.ino, ads1115.h, config.h, display.cpp, sensor.cpp, strtable.cpp]
2026-04-27 v1.5.4 - commented out all ADC and sensor type defines to enable auto release
2026-04-27 v1.5.5 - Fix filename case: ads_122C04.h → ads122c04.h (Linux compatibility)
    [ads122c04.h, config.h]
2026-04-27 v1.5.6 - fixed ADC_DRDY_PIN define/enabled it on NAU7802
    [config.h, nau7802.h]
